liawchinyi/Pre-Aligner/Pre-Aligner.kicad_pcb

## KiCad design Pre-Aligner.kicad_pcb (2022-07-05)

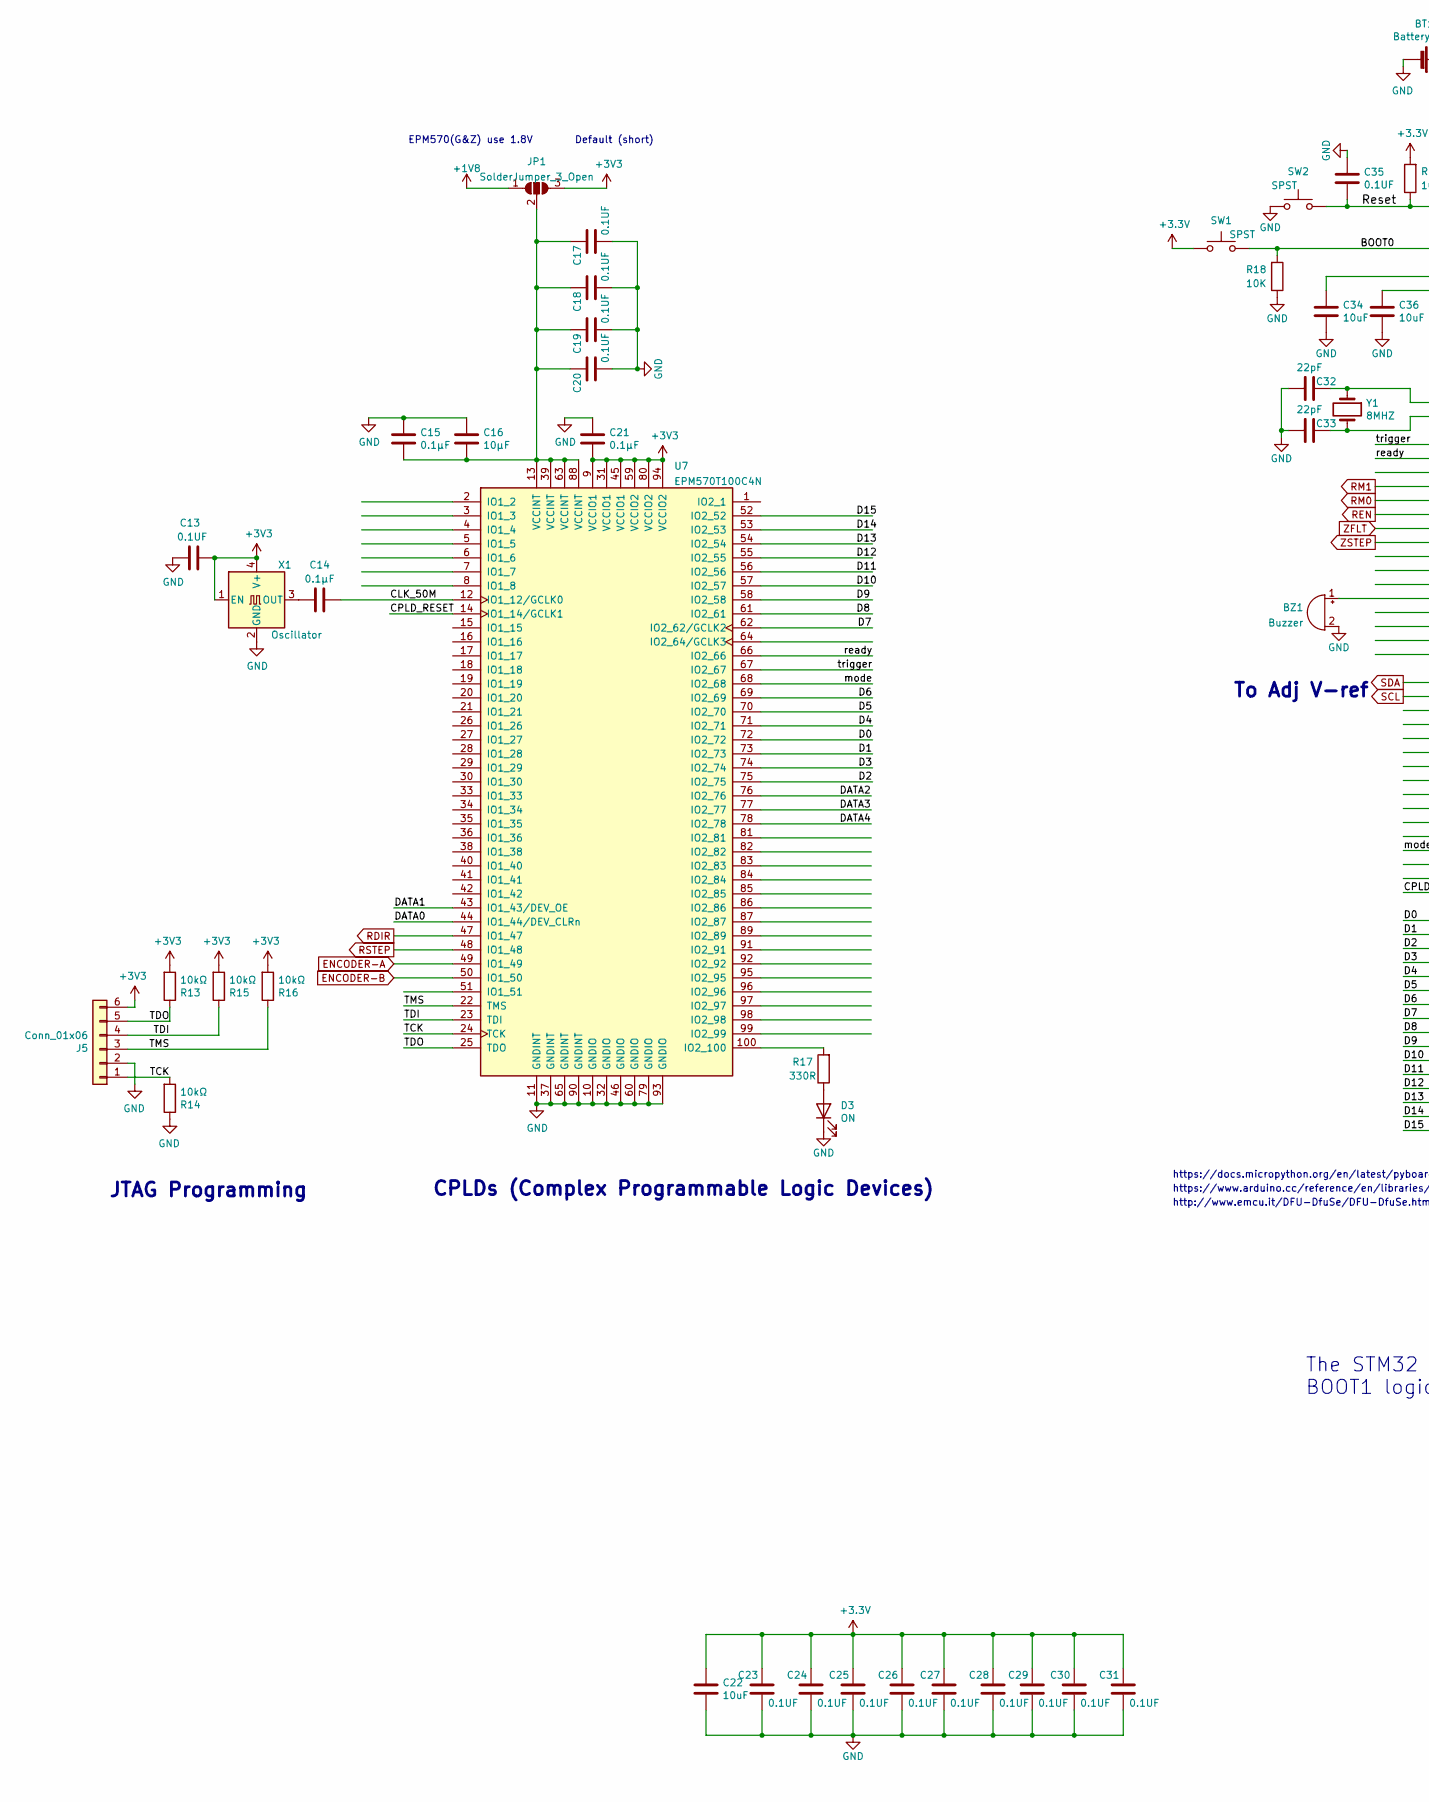
[picture p1: schematic MCU.kicad_sch, Wafer Pre-Aligner, part in row 1, column 1]

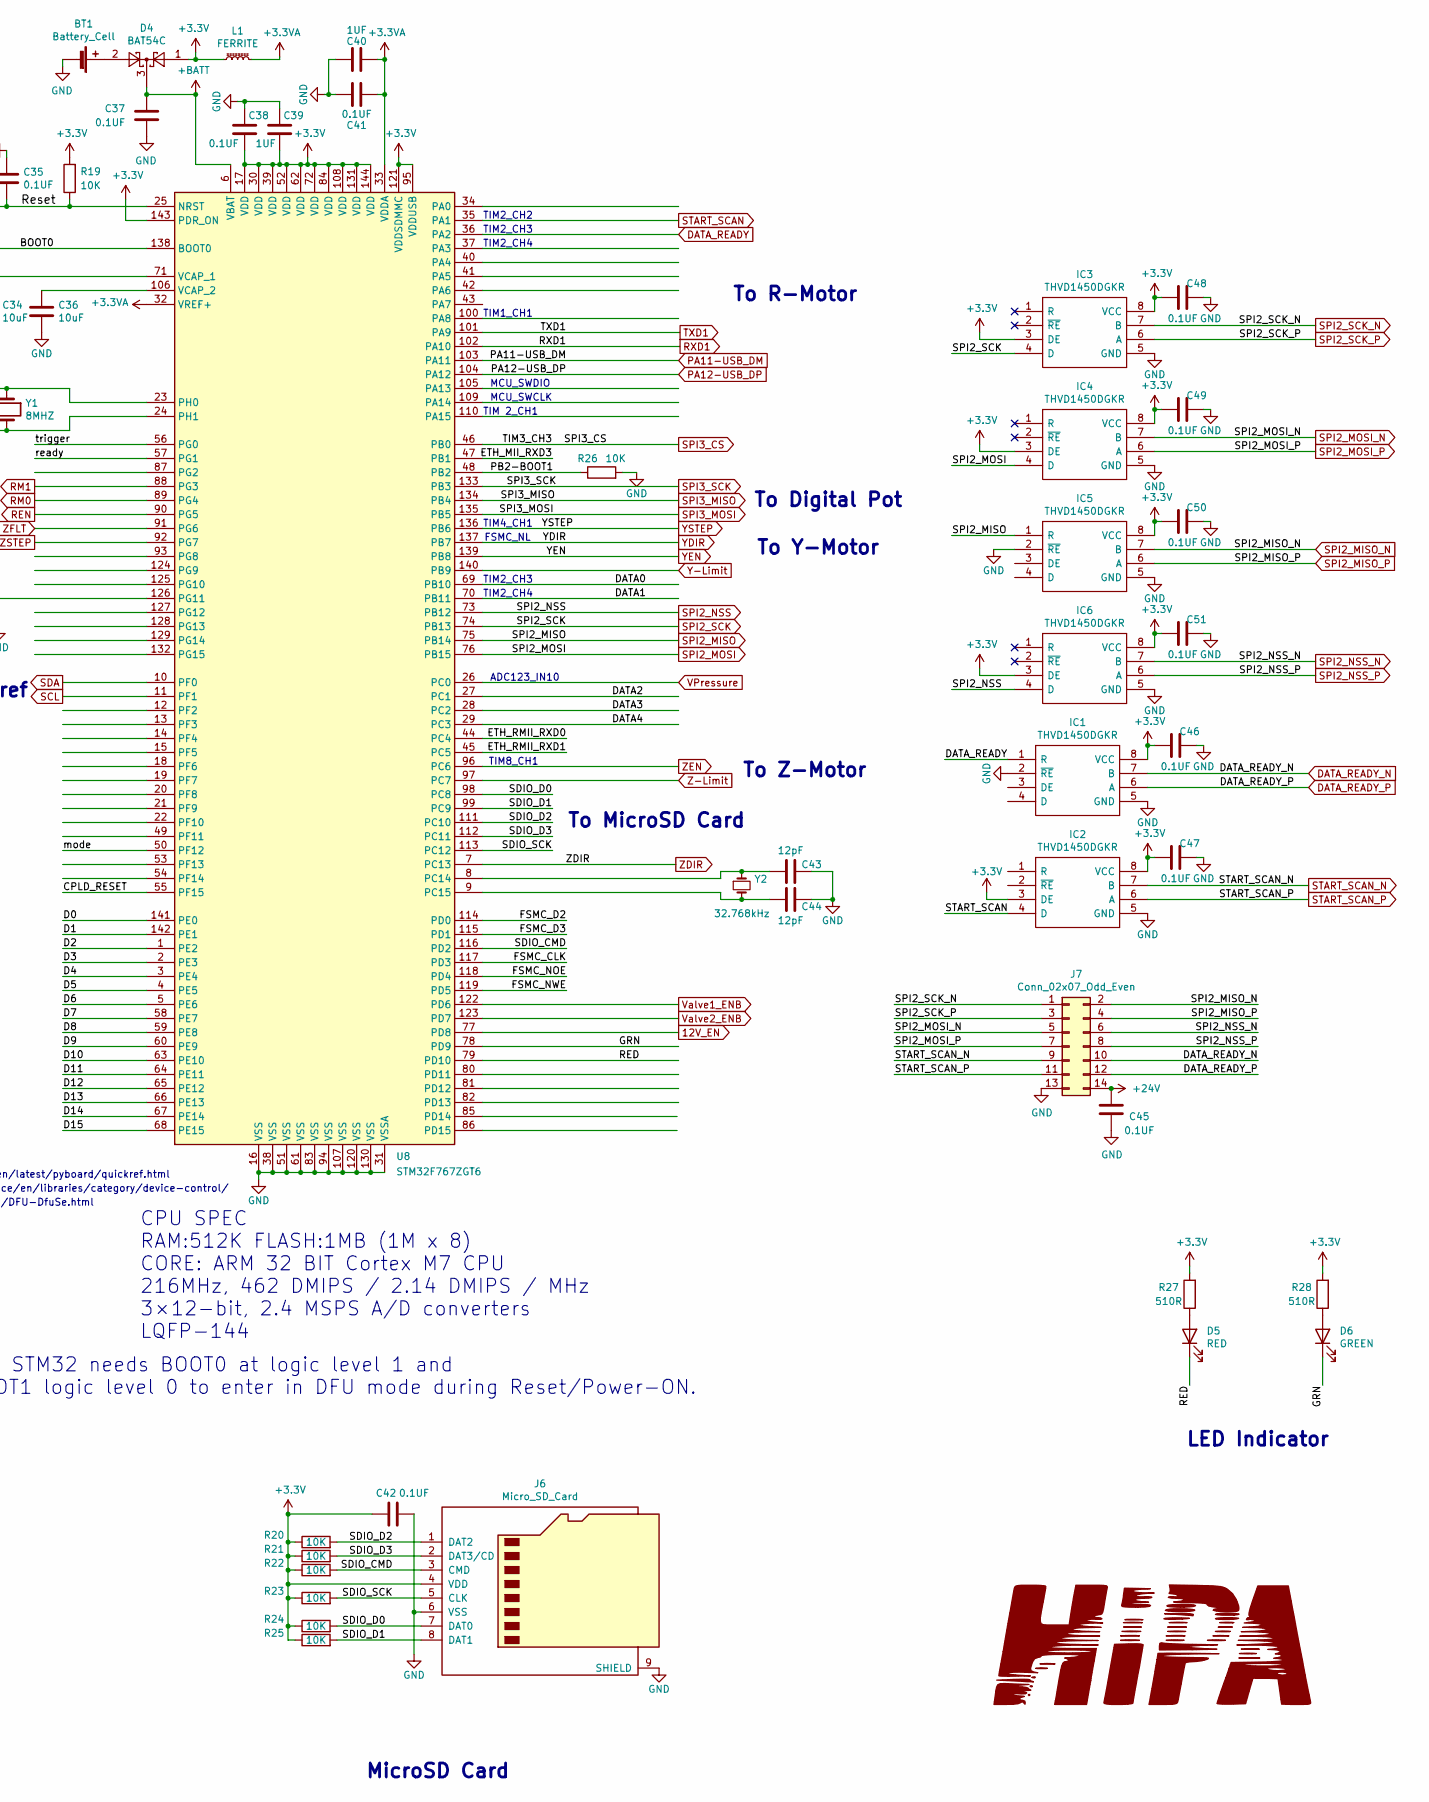
[picture p2: schematic MCU.kicad_sch, Wafer Pre-Aligner, part in row 1, column 2]

Parts:
BT1: Battery_Cell; S8411-45R; Manufacturer_Part_Number S8411-45R
BZ1: Buzzer; MagneticBuzzer_PUI_AT-0927-TT-6-R; Manufacturer_Part_Number AT-0927-TT-6-R
C13, C17, C18, C19, C20, C23, C24, C25, C26, C27, C28, C29, C30, C31, C35, C37, C38, C41, C42, C45, C46, C47, C48, C49, C50, C51: 0.1UF; C_0603_1608Metric; Manufacturer_Part_Number C0603C104M5RACTU
C14: 0.1µF; C_0402_1005Metric; Manufacturer_Part_Number GRM155R71C104KA88J
C15, C21: 0.1µF; C_0603_1608Metric; Manufacturer_Part_Number CC0603KRX7R0BB104
C16: 10µF; C_1210_3225Metric; Manufacturer_Part_Number C1210C106K5RACTU
C22, C34, C36: 10uF; C_0603_1608Metric; Manufacturer_Part_Number GRM188D71A106KA73D
C32, C33: 22pF; C_0603_1608Metric; Manufacturer_Part_Number C0603C220J1GACTU
C39, C40: 1UF; C_0603_1608Metric; Manufacturer_Part_Number CL10B105MO8NNWC
C43, C44: 12pF; C_0402_1005Metric; Manufacturer_Part_Number 04025A120FAT2A
D3: ON; LED_0805_2012Metric; Manufacturer_Part_Number LTST-C171GKT
D4: BAT54C; SOT-23; Manufacturer_Part_Number BAT54C
D5: RED; LED_0805_2012Metric; Manufacturer_Part_Number LTST-C171KRKT
D6: GREEN; LED_0805_2012Metric; Manufacturer_Part_Number LTST-C171GKT
IC1, IC2, IC3, IC4, IC5, IC6: THVD1450DGKR; SOP65P490X110-8N; Manufacturer_Part_Number THVD1450DGKR; Mouser Part Number 595-THVD1450DGKR
J5: Conn_01x06; Molex_PicoBlade_53047-0610_1x06_P1.25mm_Vertical; Manufacturer_Part_Number 0530470610
J6: Micro_SD_Card; microSD_HC_Wuerth_693072010801; Manufacturer_Part_Number 693072010801
J7: Conn_02x07_Odd_Even; PinHeader_2x07_P2.54mm_Vertical; Manufacturer_Part_Number 5103308-2
JP1: SolderJumper_3_Open; SolderJumper-3_P1.3mm_Open_RoundedPad1.0x1.5mm_NumberLabels; Manufacturer_Part_Number Empty Do not mount
L1: FERRITE; L_0603_1608Metric; Manufacturer_Part_Number 742792651
R13, R14, R15, R16: 10kΩ; R_0603_1608Metric; Manufacturer_Part_Number RNCP0603FTD10K0
R17: 330R; R_0603_1608Metric; Manufacturer_Part_Number RC0603FR-07330RL
R18, R19, R20, R21, R22, R23, R24, R25, R26: 10K; R_0603_1608Metric; Manufacturer_Part_Number ERJ-3GEYJ103V
R27, R28: 510R; R_0603_1608Metric; Manufacturer_Part_Number RC0603JR-07510RL
SW1, SW2: SPST; SW_SPST_TL3342; Manufacturer_Part_Number TL3342F160QG/TR
U7: EPM570T100C4N; LQFP-100_14x14mm_P0.5mm; Manufacturer_Part_Number EPM570T100C4N
U8: STM32F767ZGT6; LQFP-144_20x20mm_P0.5mm; Manufacturer_Part_Number STM32F767ZGT6
X1: Oscillator; Oscillator_SMD_EuroQuartz_XO32-4Pin_3.2x2.5mm; Manufacturer_Part_Number ECS-2033-500-BN
Y1: 8MHZ; Crystal_SMD_Abracon_ABM7-2Pin_6.0x3.5mm; Manufacturer_Part_Number ABM7-8.000MHZ-D2Y-T
Y2: 32.768kHz; Crystal_SMD_2012-2Pin_2.0x1.2mm_HandSoldering; Manufacturer_Part_Number SC20S-12.5PF20PPM

Connections:
12V_EN: U8.77 (PD8); also elsewhere on the board
24V: C45.1, J7.14; also elsewhere on the board
+1V8: JP1.1 (A); also elsewhere on the board
+3.3VA: C40.2, C41.2, L1.2, U8.32 (VREF+), U8.33 (VDDA)
+BATT: C37.1, D4.3, U8.6 (VBAT)
/MCU/BOOT0: R18.2, SW1.2, U8.138 (BOOT0)
/MCU/CLK_50M: C14.2, U7.12 (IO1_12/GCLK0)
/MCU/CPLD_RESET: U7.14 (IO1_14/GCLK1), U8.55 (PF15)
/MCU/D0: U7.72 (IO2_72), U8.141 (PE0)
/MCU/D1: U7.73 (IO2_73), U8.142 (PE1)
/MCU/D2: U7.75 (IO2_75), U8.1 (PE2)
/MCU/D3: U7.74 (IO2_74), U8.2 (PE3)
/MCU/D4: U7.71 (IO2_71), U8.3 (PE4)
/MCU/D5: U7.70 (IO2_70), U8.4 (PE5)
/MCU/D6: U7.69 (IO2_69), U8.5 (PE6)
/MCU/D7: U7.62 (IO2_62/GCLK2), U8.58 (PE7)
/MCU/D8: U7.61 (IO2_61), U8.59 (PE8)
/MCU/D9: U7.58 (IO2_58), U8.60 (PE9)
/MCU/D10: U7.57 (IO2_57), U8.63 (PE10)
/MCU/D11: U7.56 (IO2_56), U8.64 (PE11)
/MCU/D12: U7.55 (IO2_55), U8.65 (PE12)
/MCU/D13: U7.54 (IO2_54), U8.66 (PE13)
/MCU/D14: U7.53 (IO2_53), U8.67 (PE14)
/MCU/D15: U7.52 (IO2_52), U8.68 (PE15)
/MCU/DATA0: U7.44 (IO1_44/DEV_CLRn), U8.69 (PB10)
/MCU/DATA1: U7.43 (IO1_43/DEV_OE), U8.70 (PB11)
/MCU/DATA2: U7.76 (IO2_76), U8.27 (PC1)
/MCU/DATA3: U7.77 (IO2_77), U8.28 (PC2)
/MCU/DATA4: U7.78 (IO2_78), U8.29 (PC3)
/MCU/ETH_MII_RXD3: U8.47 (PB1)
/MCU/ETH_RMII_RXD0: U8.44 (PC4)
/MCU/ETH_RMII_RXD1: U8.45 (PC5)
/MCU/FSMC_CLK: U8.117 (PD3)
/MCU/FSMC_D2: U8.114 (PD0)
/MCU/FSMC_D3: U8.115 (PD1)
/MCU/FSMC_NOE: U8.118 (PD4)
/MCU/FSMC_NWE: U8.119 (PD5)
/MCU/GRN: D6.1 (K), U8.78 (PD9)
/MCU/PB2-BOOT1: R26.1, U8.48 (PB2)
/MCU/RED: D5.1 (K), U8.79 (PD10)
/MCU/Reset: C35.1, R19.1, SW2.2, U8.25 (NRST)
/MCU/SDIO_CMD: J6.3 (CMD), R22.2, U8.116 (PD2)
/MCU/SDIO_D0: J6.7 (DAT0), R24.2, U8.98 (PC8)
/MCU/SDIO_D1: J6.8 (DAT1), R25.2, U8.99 (PC9)
/MCU/SDIO_D2: J6.1 (DAT2), R20.2, U8.111 (PC10)
/MCU/SDIO_D3: J6.2 (DAT3/CD), R21.2, U8.112 (PC11)
/MCU/SDIO_SCK: J6.5 (CLK), R23.2, U8.113 (PC12)
/MCU/TCK: J5.1, R14.2, U7.24 (TCK)
/MCU/TDI: J5.4, R15.1, U7.23 (TDI)
/MCU/TDO: J5.5, R13.1, U7.25 (TDO)
/MCU/TMS: J5.3, R16.1, U7.22 (TMS)
/MCU/mode: U7.68 (IO2_68), U8.50 (PF12)
/MCU/ready: U7.66 (IO2_66), U8.57 (PG1)
/MCU/trigger: U7.67 (IO2_67), U8.56 (PG0)
DATA_READY: IC1.1 (R), U8.36 (PA2)
DATA_READY_N: IC1.7 (B), J7.10
DATA_READY_P: IC1.6 (A), J7.12
ENCODER-A: U7.49 (IO1_49); also elsewhere on the board
ENCODER-B: U7.50 (IO1_50); also elsewhere on the board
GND: BT1.2 (-), BZ1.2 (+), C13.1, C15.1, C16.1, C17.1, C18.1, C19.1, C20.1, C21.1, C22.1, C23.1, C24.1, C25.1, C26.1, C27.1, C28.1, C29.1, C30.1, C31.1, C32.2, C33.2, C34.1, C35.2, C36.1, C37.2, C38.2, C39.2, C40.1, C41.1, C42.1, C43.1, C44.2, C45.2, C46.2, C47.2, C48.2, C49.2, C50.2, C51.2, D3.1 (K), IC1.2 (~RE), IC1.5 (GND), IC2.5 (GND), IC3.5 (GND), IC4.5 (GND), IC5.2 (~RE), IC5.5 (GND), IC6.5 (GND), J5.2, J6.6 (VSS), J6.9 (SHIELD), J7.13, R14.1, R18.1, R26.2, SW2.1, U7.10 (GNDIO), U7.11 (GNDINT), U7.32 (GNDIO), U7.37 (GNDINT), U7.46 (GNDIO), U7.60 (GNDIO), U7.65 (GNDINT), U7.79 (GNDIO), U7.90 (GNDINT), U7.93 (GNDIO), U8.16 (VSS), U8.31 (VSSA), U8.38 (VSS), U8.51 (VSS), U8.61 (VSS), U8.83 (VSS), U8.94 (VSS), U8.107 (VSS), U8.120 (VSS), U8.130 (VSS), X1.2 (GND); also elsewhere on the board
unnamed: BT1.1 (+), D4.2
unnamed: BZ1.1 (-), U8.126 (PG11)
unnamed: C14.1, X1.3 (OUT)
unnamed: C15.2, C16.2, C17.2, C18.2, C19.2, C20.2, JP1.2 (C), U7.13 (VCCINT), U7.39 (VCCINT), U7.63 (VCCINT), U7.88 (VCCINT)
unnamed: C32.1, U8.23 (PH0), Y1.1
unnamed: C33.1, U8.24 (PH1), Y1.2
unnamed: C34.2, U8.71 (VCAP_1)
unnamed: C36.2, U8.106 (VCAP_2)
unnamed: C43.2, U8.8 (PC14), Y2.1
unnamed: C44.1, U8.9 (PC15), Y2.2
unnamed: D3.2 (A), R17.1
unnamed: D5.2 (A), R27.1
unnamed: D6.2 (A), R28.1
unnamed: R17.2, U7.100 (IO2_100)
PA11-USB_DM: U8.103 (PA11); also elsewhere on the board
PA12-USB_DP: U8.104 (PA12); also elsewhere on the board
RDIR: U7.47 (IO1_47); also elsewhere on the board
REN: U8.90 (PG5); also elsewhere on the board
RM0: U8.89 (PG4); also elsewhere on the board
RM1: U8.88 (PG3); also elsewhere on the board
RSTEP: U7.48 (IO1_48); also elsewhere on the board
RXD1: U8.102 (PA10); also elsewhere on the board
SCL: U8.11 (PF1); also elsewhere on the board
SDA: U8.10 (PF0); also elsewhere on the board
SPI2_MISO: IC5.1 (R), U8.75 (PB14)
SPI2_MISO_N: IC5.7 (B), J7.2
SPI2_MISO_P: IC5.6 (A), J7.4
SPI2_MOSI: IC4.4 (D), U8.76 (PB15)
SPI2_MOSI_N: IC4.7 (B), J7.5
SPI2_MOSI_P: IC4.6 (A), J7.7
SPI2_NSS: IC6.4 (D), U8.73 (PB12)
SPI2_NSS_N: IC6.7 (B), J7.6
SPI2_NSS_P: IC6.6 (A), J7.8
SPI2_SCK: IC3.4 (D), U8.74 (PB13)
SPI2_SCK_N: IC3.7 (B), J7.1
SPI2_SCK_P: IC3.6 (A), J7.3
SPI3_CS: U8.46 (PB0); also elsewhere on the board
SPI3_MISO: U8.134 (PB4)
SPI3_MOSI: U8.135 (PB5); also elsewhere on the board
SPI3_SCK: U8.133 (PB3); also elsewhere on the board
START_SCAN: IC2.4 (D), U8.35 (PA1)
START_SCAN_N: IC2.7 (B), J7.9
START_SCAN_P: IC2.6 (A), J7.11
TXD1: U8.101 (PA9); also elsewhere on the board
VPressure: U8.26 (PC0); also elsewhere on the board
Valve1_ENB: U8.122 (PD6); also elsewhere on the board
Valve2_ENB: U8.123 (PD7); also elsewhere on the board
Y-Limit: U8.140 (PB9); also elsewhere on the board
YDIR: U8.137 (PB7); also elsewhere on the board
YEN: U8.139 (PB8); also elsewhere on the board
YSTEP: U8.136 (PB6); also elsewhere on the board
Z-Limit: U8.97 (PC7); also elsewhere on the board
ZDIR: U8.7 (PC13); also elsewhere on the board
ZEN: U8.96 (PC6); also elsewhere on the board
ZFLT: U8.91 (PG6); also elsewhere on the board
ZSTEP: U8.92 (PG7); also elsewhere on the board

Notes on the sheet:
TIM2_CH4
TIM4_CH1
TIM2_CH3
MicroSD Card
To Z-Motor
LED Indicator
TIM8_CH1
ADC123_IN10
http://www.emcu.it/DFU-DfuSe/DFU-DfuSe.html
To MicroSD Card
MCU_SWDIO
Default (short)
https://docs.micropython.org/en/latest/pyboard/quickref.html
TIM 2_CH1
TIM1_CH1
CPU SPEC RAM:512K FLASH:1MB (1M x 8) CORE: ARM 32 BIT Cortex M7 CPU 216MHz, 462 DMIPS / 2.14 DMIPS / MHz 3×12-bit, 2.4 MSPS A/D converters LQFP-144
CPLDs (Complex Programmable Logic Devices)
MCU_SWCLK
https://www.arduino.cc/reference/en/libraries/category/device-control/
To Y-Motor
TIM2_CH2
JTAG Programming
FSMC_NL
To Adj V-ref
To R-Motor
The STM32 needs BOOT0 at logic level 1 and BOOT1 logic level 0 to enter in DFU mode during Reset/Power-ON.
To Digital Pot
EPM570(G&Z) use 1.8V

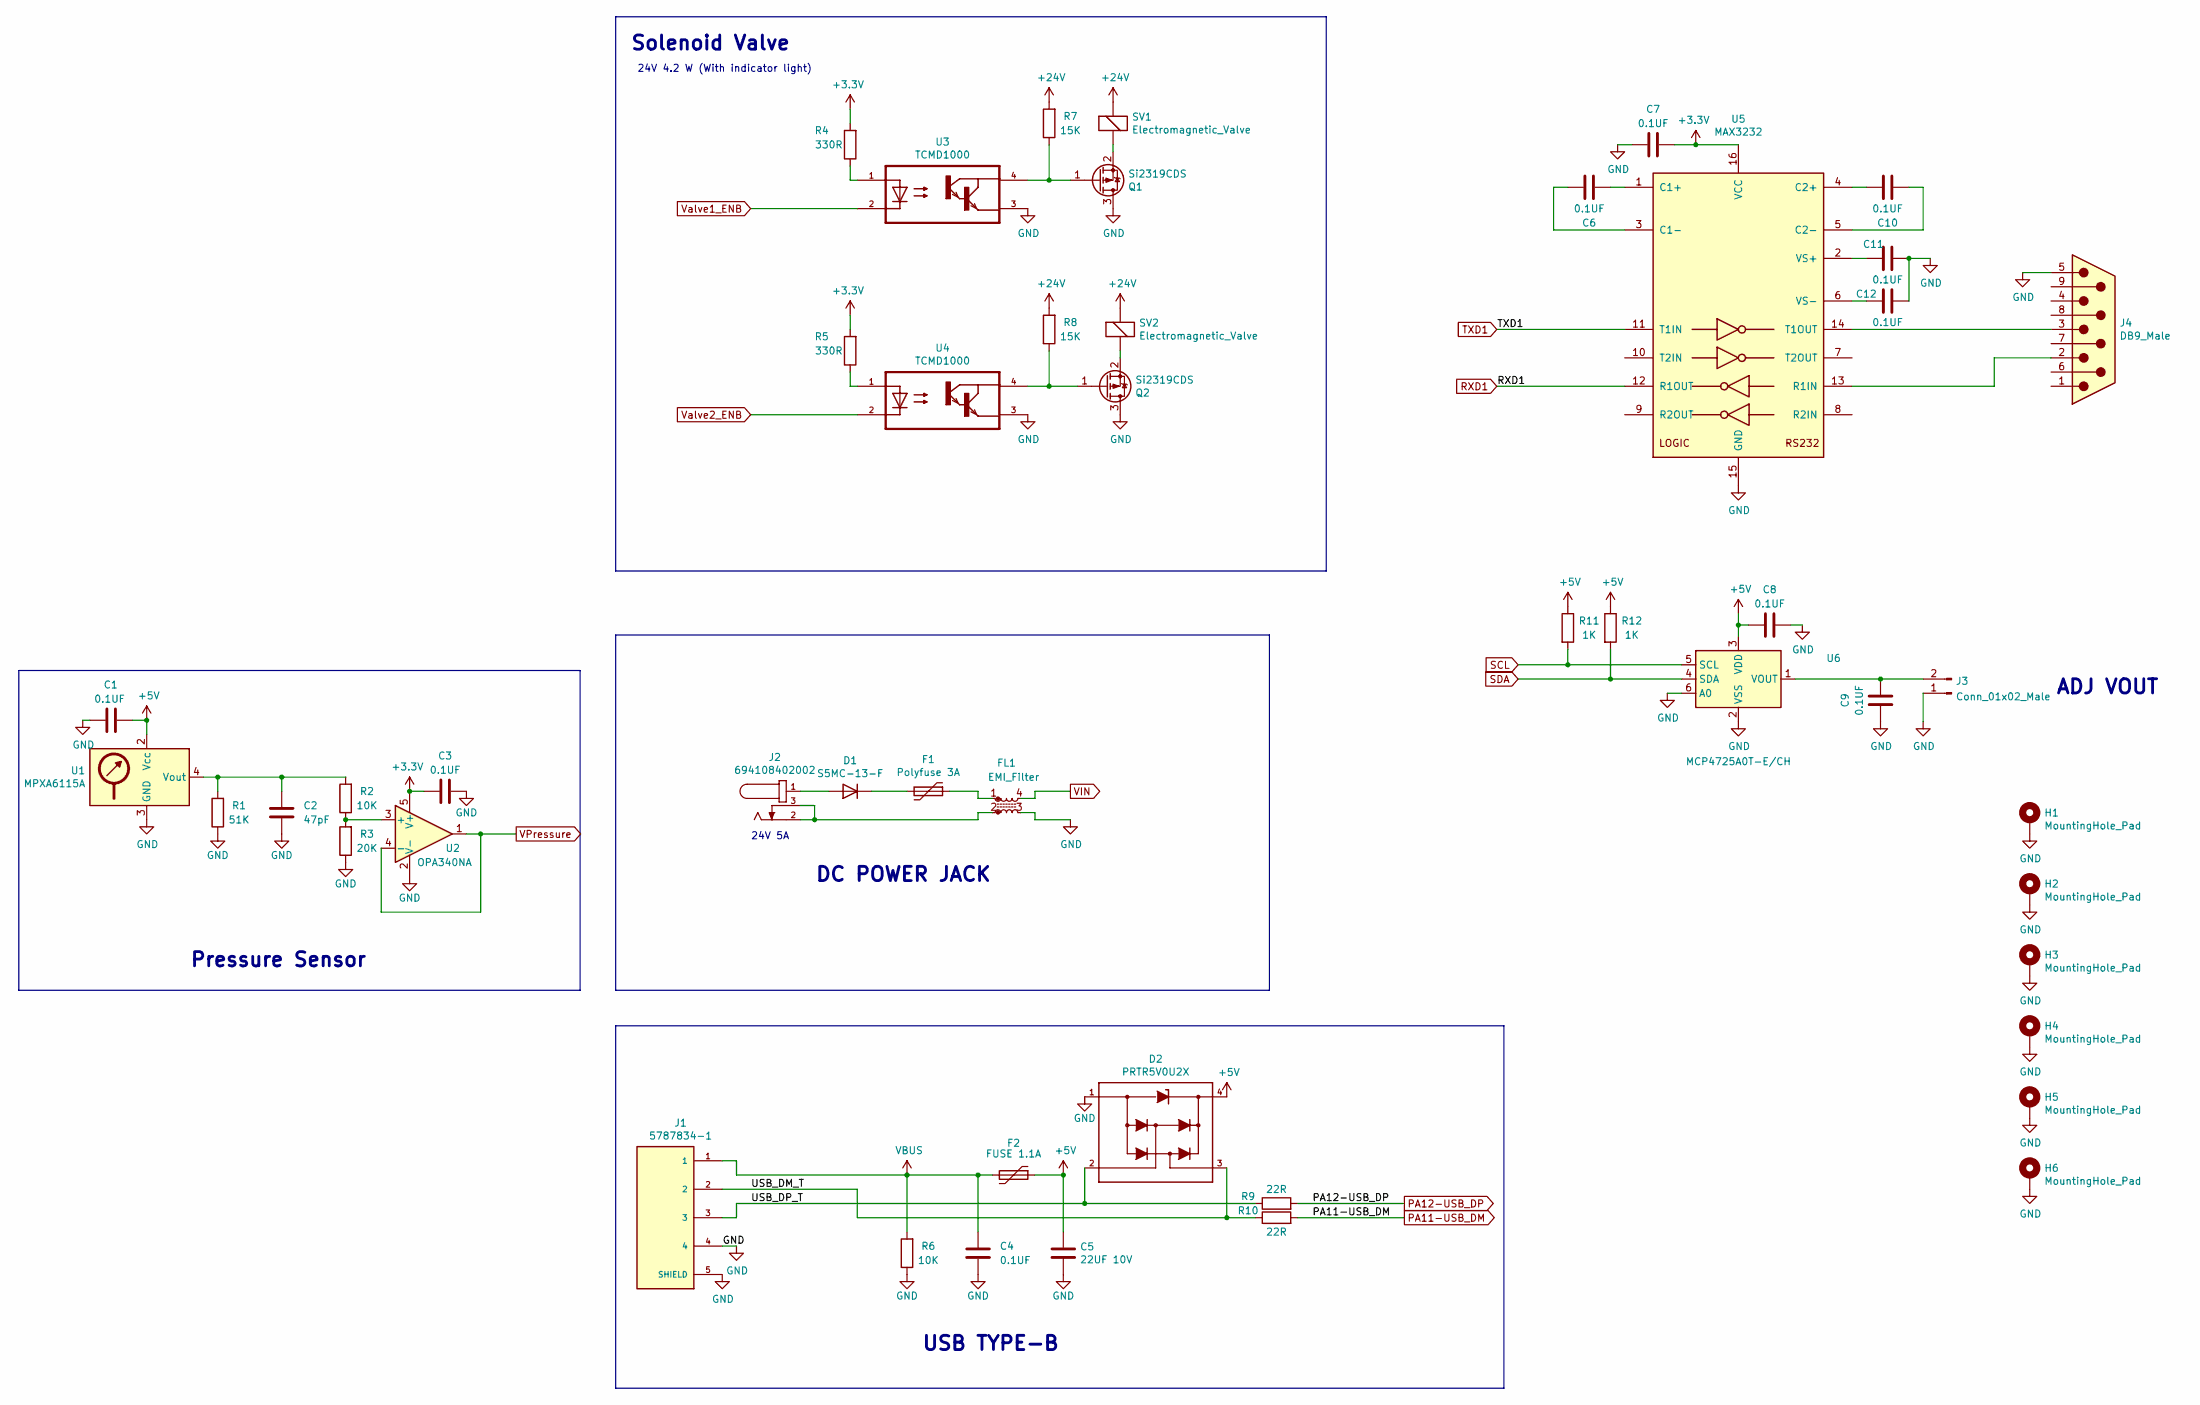
[picture p3: schematic Interface.kicad_sch]

Parts:
C1, C3, C4, C6, C7, C8, C9, C10, C11, C12: 0.1UF; C_0603_1608Metric; Manufacturer_Part_Number C0603C104M5RACTU
C2: 47pF; C_0603_1608Metric; Manufacturer_Part_Number 251R14S470GV4T
C5: 22UF 10V; C_0805_2012Metric; Manufacturer_Part_Number GRM21BR61A226ME51L
D1: S5MC-13-F; Manufacturer_Part_Number S5MC-13-F
D2: PRTR5V0U2X; SOT190P230X110-4N; Manufacturer_Part_Number PRTR5V0U2X,215
F1: Polyfuse 3A; Fuse_Bourns_MF-RHT1300; Manufacturer_Part_Number MF-RX300/72-2
F2: FUSE 1.1A; Fuse_1812_4532Metric_Pad1.30x3.40mm_HandSolder; Manufacturer_Part_Number 1812L110/33MR
FL1: EMI_Filter; ACM7060-701-2PL-TL; Manufacturer_Part_Number ACM7060-701-2PL-TL01
H1, H2, H3, H4, H5, H6: MountingHole_Pad; MountingHole_3.5mm_Pad; Manufacturer_Part_Number Empty Do not mount
J1: 5787834-1; USB_B_TE_5787834_Vertical; Manufacturer_Part_Number 5787834-1
J2: 694108402002; Manufacturer_Part_Number 694108402002
J3: Conn_01x02_Male; Molex_KK-254_AE-6410-02A_1x02_P2.54mm_Vertical; Manufacturer_Part_Number 0022272021
J4: DB9_Male; DSUB-9_Male_Vertical_P2.77x2.84mm_MountingHoles; Manufacturer_Part_Number 5747871-8
Q1, Q2: Si2319CDS; SOT-23; Manufacturer_Part_Number SI2319CDS-T1-BE3
R1: 51K; R_0603_1608Metric; Manufacturer_Part_Number RR0816P-513-D
R2, R6: 10K; R_0603_1608Metric; Manufacturer_Part_Number ERJ-3GEYJ103V
R3: 20K; R_0603_1608Metric; Manufacturer_Part_Number ERA-3AEB203V
R4, R5: 330R; R_0603_1608Metric; Manufacturer_Part_Number RC0603JR-07330RL
R7, R8: 15K; R_0603_1608Metric; Manufacturer_Part_Number ERA-3AEB153V
R9, R10: 22R; R_0603_1608Metric; Manufacturer_Part_Number RC0603FR-0722RL
R11, R12: 1K; R_0603_1608Metric; Manufacturer_Part_Number RC0603JR-071KL
SV1, SV2: Electromagnetic_Valve; Molex_KK-254_AE-6410-02A_1x02_P2.54mm_Vertical; Manufacturer_Part_Number 0022272021
U1: MPXA6115A; SOP254P1821X584-8N; Manufacturer_Part_Number MPXA6115AC6U
U2: OPA340NA; SOT-23-5; Manufacturer_Part_Number OPA340NA/3K
U3, U4: TCMD1000; SOP127P695X210-4N; Manufacturer_Part_Number TCMD1000
U5: MAX3232; SOIC-16_3.9x9.9mm_P1.27mm; Manufacturer_Part_Number MAX3232ESE+T
U6: MCP4725A0T-E/CH; SOT-23-6; Manufacturer_Part_Number MCP4725A0T-E/CH

Connections:
24V: R7.2, R8.2, SV1.1 (-), SV2.1 (-); also elsewhere on the board
+5V: C1.2, C5.1, C8.2, D2.4, F2.1, R11.1, R12.1, U1.2 (Vcc), U6.3 (VDD); also elsewhere on the board
/Interface/USB_DM_T: D2.3, J1.2, R10.1
/Interface/USB_DP_T: D2.2, J1.3, R9.1
GND: C1.1, C2.2, C3.1, C4.2, C5.2, C7.2, C8.1, C9.2, C11.2, C12.2, D2.1, FL1.3, H1.1, H2.1, H3.1, H4.1, H5.1, H6.1, J1.4, J1.5 (SHIELD), J3.1, J4.5, Q1.3 (D), Q2.3 (D), R1.1, R3.1, R6.1, U1.3 (GND), U2.2 (V-), U3.3, U4.3, U5.15 (GND), U6.2 (VSS), U6.6 (A0); also elsewhere on the board
unnamed: C2.1, R1.2, R2.2, U1.4 (Vout)
unnamed: C6.1, U5.3 (C1-)
unnamed: C6.2, U5.1 (C1+)
unnamed: C9.1, J3.2, U6.1 (VOUT)
unnamed: C10.1, U5.4 (C2+)
unnamed: C10.2, U5.5 (C2-)
unnamed: C11.1, U5.2 (VS+)
unnamed: C12.1, U5.6 (VS-)
unnamed: D1.1 (K), F1.2
unnamed: D1.2 (A), J2.1
unnamed: F1.1, FL1.1
unnamed: FL1.2, J2.2, J2.3
unnamed: J4.2, U5.13 (R1IN)
unnamed: J4.3, U5.14 (T1OUT)
unnamed: Q1.1 (G), R7.1, U3.4
unnamed: Q1.2 (S), SV1.2 (+)
unnamed: Q2.1 (G), R8.1, U4.4
unnamed: Q2.2 (S), SV2.2 (+)
unnamed: R2.1, R3.2, U2.3 (+)
unnamed: R4.1, U3.1
unnamed: R5.1, U4.1
PA11-USB_DM: R10.2; also elsewhere on the board
PA12-USB_DP: R9.2; also elsewhere on the board
RXD1: U5.12 (R1OUT); also elsewhere on the board
SCL: R11.2, U6.5 (SCL); also elsewhere on the board
SDA: R12.2, U6.4 (SDA); also elsewhere on the board
TXD1: U5.11 (T1IN); also elsewhere on the board
VBUS: C4.1, F2.2, J1.1, R6.2
VIN: FL1.4; also elsewhere on the board
VPressure: U2.1, U2.4 (-); also elsewhere on the board
Valve1_ENB: U3.2; also elsewhere on the board
Valve2_ENB: U4.2; also elsewhere on the board

Notes on the sheet:
USB TYPE-B
ADJ VOUT
24V 4.2 W (With indicator light)
Pressure Sensor
24V 5A
Solenoid Valve
DC POWER JACK

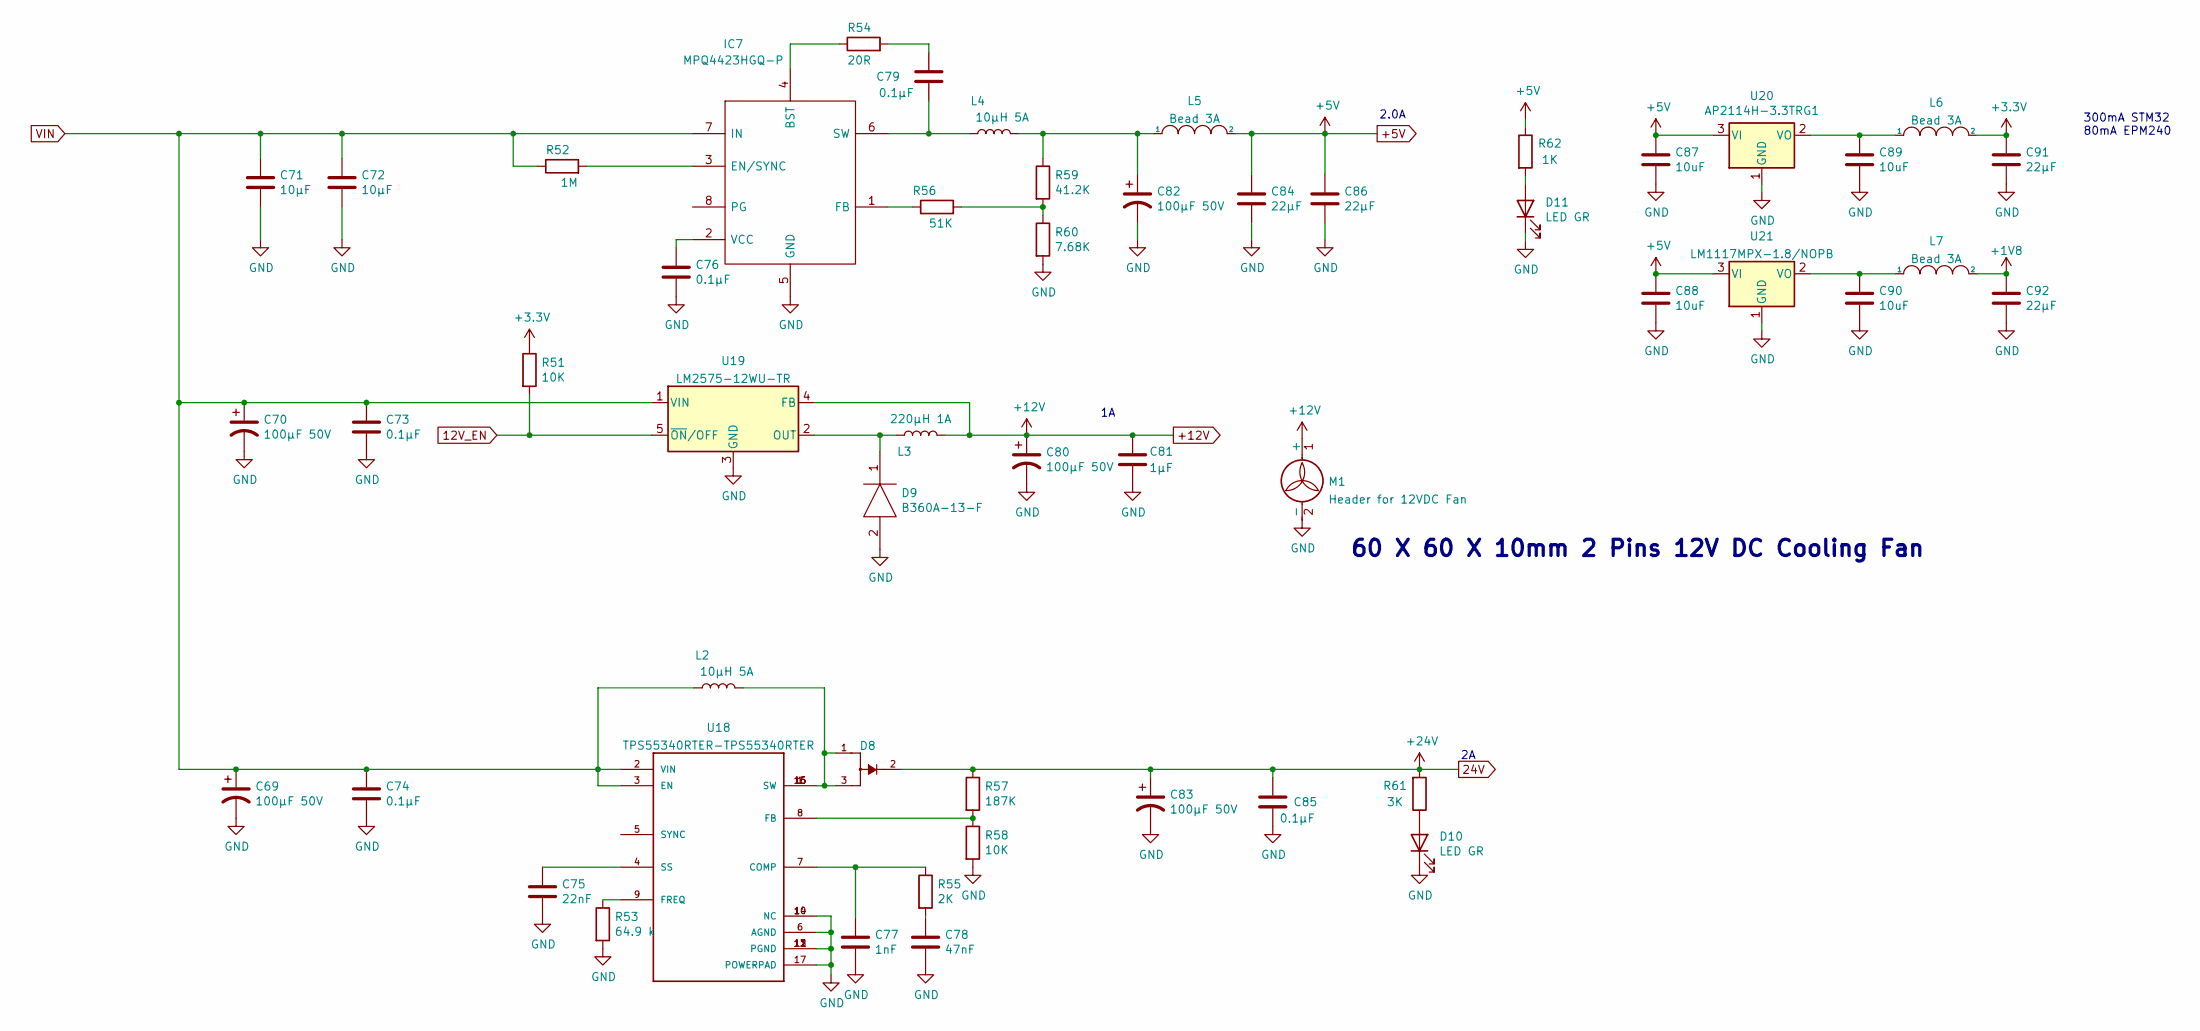
[picture p4: schematic Power Supply.kicad_sch]

Parts:
C69, C70, C80, C82, C83: 100µF 50V; CP_Elec_10x10; Manufacturer_Part_Number EEE-FC1H101P
C71, C72: 10µF; C_1210_3225Metric; Manufacturer_Part_Number C1210C106K5RACTU
C73, C74, C76, C79: 0.1µF; C_0603_1608Metric; Manufacturer_Part_Number CC0603KRX7R0BB104
C75: 22nF; C_0603_1608Metric; Manufacturer_Part_Number MC0603B223K500CT
C77: 1nF; C_0603_1608Metric; Manufacturer_Part_Number CC0603KRX7R9BB102
C78: 47nF; C_0603_1608Metric; Manufacturer_Part_Number MC0603B473K500CT
C81: 1µF; C_0603_1608Metric; Manufacturer_Part_Number Samsung Electro-Mechanics
C84, C86, C91, C92: 22µF; C_1210_3225Metric; Manufacturer_Part_Number CGA6P1X7R1C226M250AC
C85: 0.1µF; C_0402_1005Metric; Manufacturer_Part_Number GRM155R71C104KA88J
C87, C88, C89, C90: 10uF; C_0603_1608Metric; Manufacturer_Part_Number GRM188D71A106KA73D
D8: SBRD10200TR; ATPAK-2; Manufacturer_Part_Number SBRD10200
D9: B360A-13-F; DIOM5226X240N; Manufacturer_Part_Number B360A-13-F; Mouser Part Number 621-B360A-F
D10: LED GR; LED_D5.0mm; Manufacturer_Part_Number LTL-307GLC
D11: LED GR; LED_0805_2012Metric; Manufacturer_Part_Number LTST-C171GKT
IC7: MPQ4423HGQ-P; SON65P300X300X100-8N-D; Manufacturer_Part_Number MPQ4423HGQ-P; Mouser Part Number 946-MPQ4423HGQ-P
L2, L4: 10µH 5A; L_12x12mm_H6mm; Manufacturer_Part_Number 74477110
L3: 220µH 1A; L_Wuerth_HCM-7070; Manufacturer_Part_Number 74404084221
L5, L6, L7: Bead 3A; L_1210_3225Metric; Manufacturer_Part_Number FBMH3225HM601NT
M1: Header for 12VDC Fan; Molex_KK-254_AE-6410-02A_1x02_P2.54mm_Vertical; Manufacturer_Part_Number 0022272021
R51: 10K; R_0603_1608Metric; Manufacturer_Part_Number RT0603DRD0710KL
R52: 1M; R_0603_1608Metric; Manufacturer_Part_Number HVCB0603FDC1M00
R53: 64.9 k; R_0603_1608Metric; Manufacturer_Part_Number RC0603FR-0764K9L
R54: 20R; R_0603_1608Metric; Manufacturer_Part_Number RC0603FR-0720RL
R55: 2K; R_0603_1608Metric; Manufacturer_Part_Number RNCP0603FTD2K00
R56: 51K; R_0603_1608Metric; Manufacturer_Part_Number RT0603FRE0751KL
R57: 187K; R_0603_1608Metric; Manufacturer_Part_Number RMCF0603FT187K
R58: 10K; R_0603_1608Metric; Manufacturer_Part_Number RNCF0603TKY10K0
R59: 41.2K; R_0603_1608Metric; Manufacturer_Part_Number RMCF0603FT41K2
R60: 7.68K; R_0603_1608Metric; Manufacturer_Part_Number RT0603BRE077K68L
R61: 3K; R_0805_2012Metric; Manufacturer_Part_Number ERA-6AEB302V
R62: 1K; R_0603_1608Metric; Manufacturer_Part_Number RC0603JR-071KL
U18: TPS55340RTER-TPS55340RTER; QFN50P300X300X100-17N; Manufacturer_Part_Number TPS55340RTER
U19: LM2575-12WU-TR; TO-263-5_TabPin3; Manufacturer_Part_Number LM2575-12WU-TR
U20: AP2114H-3.3TRG1; SOT-223-3_TabPin2; Manufacturer_Part_Number AP2114H-3.3TRG1
U21: LM1117MPX-1.8/NOPB; SOT-223-3_TabPin2; Manufacturer_Part_Number LM1117MPX-1.8/NOPB

Connections:
12V_EN: R51.2, U19.5 (~ON/OFF); also elsewhere on the board
24V: C83.1, C85.1, D8.2, R57.1, R61.2; also elsewhere on the board
+1V8: C92.1, L7.2; also elsewhere on the board
+5V: C84.1, C86.1, C87.2, C88.2, L5.2, R62.1, U20.3 (VI), U21.3 (VI); also elsewhere on the board
+12V: C80.1, C81.2, L3.2, M1.1 (+), U19.4 (FB)
GND: C69.2, C70.2, C71.2, C72.2, C73.2, C74.2, C75.2, C76.2, C77.2, C78.2, C80.2, C81.1, C82.2, C83.2, C84.2, C85.2, C86.2, C87.1, C88.1, C89.1, C90.1, C91.2, C92.2, D9.2, D10.1 (K), D11.1 (K), IC7.5 (GND), M1.2 (-), R53.2, R58.2, R60.2, U18.6 (AGND), U18.10 (NC), U18.11 (PGND), U18.12 (PGND), U18.13 (PGND), U18.14 (NC), U18.17 (POWERPAD), U19.3 (GND), U20.1 (GND), U21.1 (GND); also elsewhere on the board
unnamed: C75.1, U18.4 (SS)
unnamed: C76.1, IC7.2 (VCC)
unnamed: C77.1, R55.1, U18.7 (COMP)
unnamed: C78.1, R55.2
unnamed: C79.1, R54.2
unnamed: C79.2, IC7.6 (SW), L4.1
unnamed: C82.1, L4.2, L5.1, R59.1
unnamed: C89.2, L6.1, U20.2 (VO)
unnamed: C90.2, L7.1, U21.2 (VO)
unnamed: D8.1, D8.3, L2.2, U18.1 (SW), U18.15 (SW), U18.16 (SW)
unnamed: D9.1, L3.1, U19.2 (OUT)
unnamed: D10.2 (A), R61.1
unnamed: D11.2 (A), R62.2
unnamed: IC7.1 (FB), R56.1
unnamed: IC7.3 (EN/SYNC), R52.2
unnamed: IC7.4 (BST), R54.1
unnamed: R53.1, U18.9 (FREQ)
unnamed: R56.2, R59.2, R60.1
unnamed: R57.2, R58.1, U18.8 (FB)
VIN: C69.1, C70.1, C71.1, C72.1, C73.1, C74.1, IC7.7 (IN), L2.1, R52.1, U18.2 (VIN), U18.3 (EN), U19.1 (VIN); also elsewhere on the board

Notes on the sheet:
2.0A
300mA STM32 80mA EPM240
60 X 60 X 10mm 2 Pins 12V DC Cooling Fan
