liawchinyi/Pre-Aligner/Pre-Aligner.kicad_pcb

## KiCad design Pre-Aligner.kicad_pcb (continued)

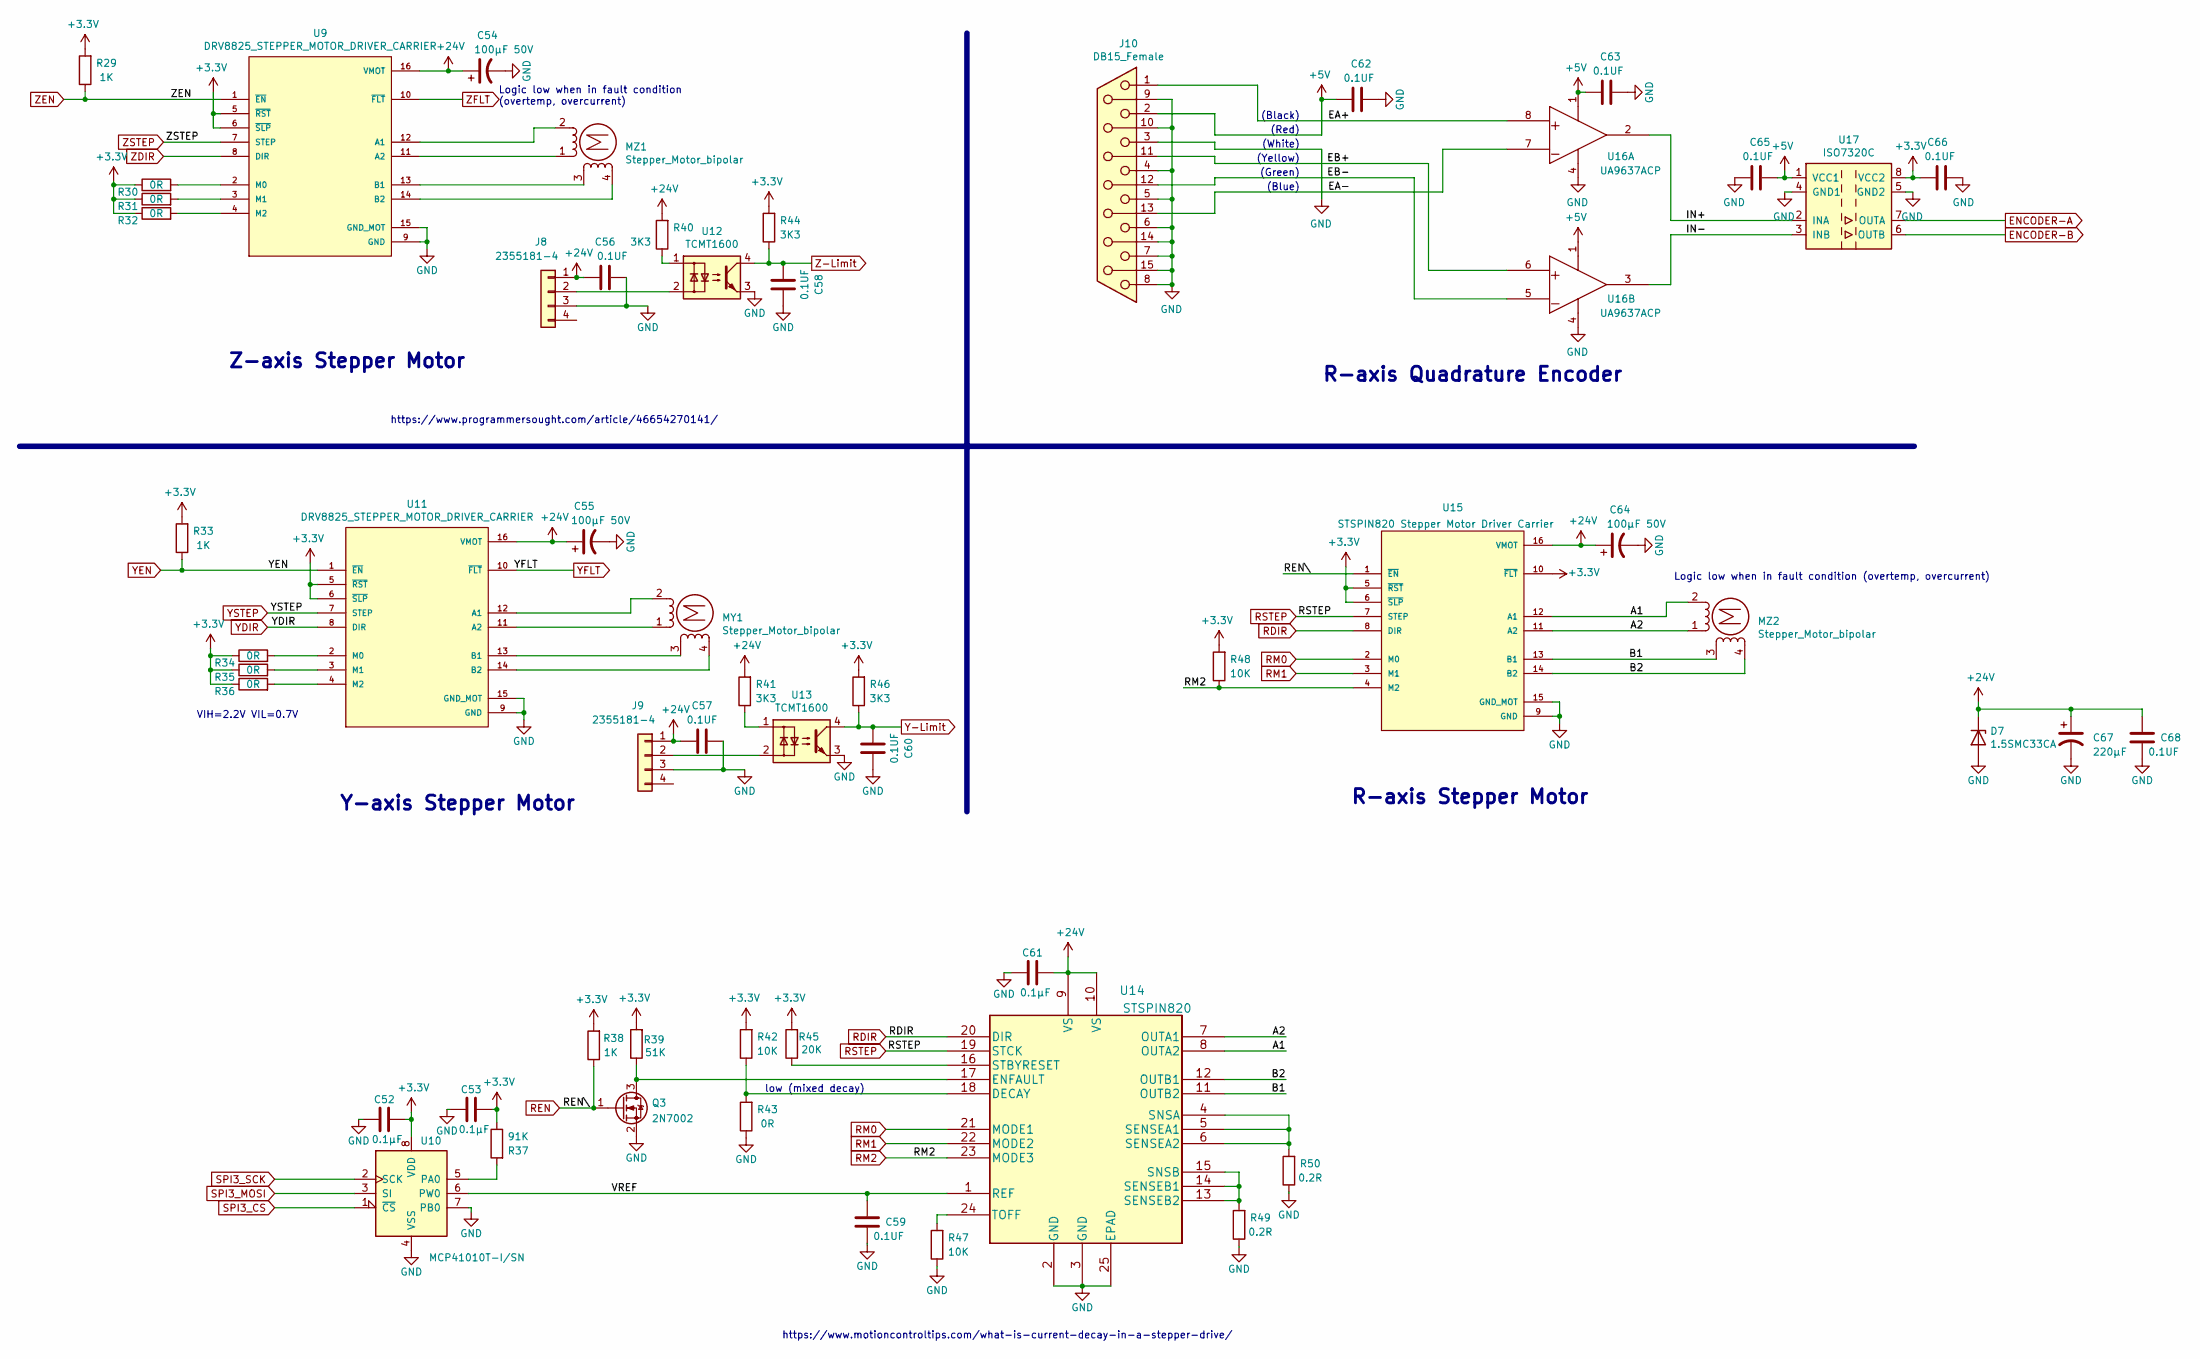
[picture p5: schematic MOTOR.kicad_sch, Wafer Pre-Aligner]

Parts:
C52, C53, C61: 0.1µF; C_0402_1005Metric; Manufacturer_Part_Number GRM155R71C104KA88J
C54, C55, C64: 100µF 50V; CP_Elec_10x10; Manufacturer_Part_Number EEE-FC1H101P
C56, C57, C58, C59, C60, C62, C63, C65, C66, C68: 0.1UF; C_0603_1608Metric; Manufacturer_Part_Number C0603C104M5RACTU
C67: 220µF; CP_Elec_10x10.5; Manufacturer_Part_Number UWT1H221MNL1GS
D7: 1.5SMC33CA; D_SMC; Manufacturer_Part_Number 1.5SMC33CA
J8, J9: 2355181-4; TE_440054-4; Manufacturer_Part_Number 2355181-4
J10: DB15_Female; DSUB-15-HD_Female_Vertical_P2.29x1.98mm_MountingHoles; Manufacturer_Part_Number 10090929-S154XLF
MY1: Stepper_Motor_bipolar; JST_EH_B4B-EH-A_1x04_P2.50mm_Vertical; Manufacturer_Part_Number 640456-4
MZ1, MZ2: Stepper_Motor_bipolar; JST_EH_B4B-EH-A_1x04_P2.50mm_Vertical; Manufacturer_Part_Number 640456-4
Q3: 2N7002; SOT-23; Manufacturer_Part_Number 2N7002
R29, R33, R38: 1K; R_0603_1608Metric; Manufacturer_Part_Number RC0603JR-071KL
R30, R31, R32, R34, R35, R36: 0R; R_0603_1608Metric; Manufacturer_Part_Number RMCF0603ZT0R00
R37: 91K; R_0603_1608Metric; Manufacturer_Part_Number ERJ-3GEYJ913V
R39: 51K; R_0603_1608Metric; Manufacturer_Part_Number RT0603FRE0751KL
R40, R41, R44, R46: 3K3; R_0603_1608Metric; Manufacturer_Part_Number ERJ-3GEYJ332V
R42, R47, R48: 10K; R_0603_1608Metric; Manufacturer_Part_Number ERJ-3GEYJ103V
R43: 0R; R_0603_1608Metric; Manufacturer_Part_Number CR0603AJ/-000EAS
R45: 20K; R_0603_1608Metric; Manufacturer_Part_Number ERA-3AEB203V
R49, R50: 0.2R; RES_ERJB1CFR036U; Manufacturer_Part_Number ERJ-D1CFR200U
U9, U11: DRV8825_STEPPER_MOTOR_DRIVER_CARRIER; Manufacturer_Part_Number DRV8825
U10: MCP41010T-I/SN; SOIC-8-1EP_3.9x4.9mm_P1.27mm_EP2.29x3mm; Manufacturer_Part_Number MCP41010T-I/SN
U12, U13: TCMT1600; SOP-4_4.4x2.6mm_P1.27mm; Manufacturer_Part_Number TCMT1600
U14: STSPIN820; QFN_SPIN820_STM; Manufacturer_Part_Number STSPIN820
U15: STSPIN820 Stepper Motor Driver Carrier; SPSPIN820_STEPPER_MOTOR_DRIVER_CARRIER; Manufacturer_Part_Number STSPIN820
U16: UA9637ACP; DIP-8_W7.62mm; Manufacturer_Part_Number UA9637ACDR
U17: ISO7320C; SOIC-8_3.9x4.9mm_P1.27mm; Manufacturer_Part_Number ISO7320CQDRQ1

Connections:
24V: C54.1, C55.1, C56.1, C57.1, C61.2, C64.1, C67.1, C68.2, D7.1 (K), J8.1, J9.1, R40.2, R41.2, U9.16 (VMOT), U11.16 (VMOT), U14.9 (VS), U14.10 (VS), U15.16 (VMOT); also elsewhere on the board
+5V: C62.2, C63.2, C65.1, J10.2, U16.1 (VCC), U17.1 (VCC1); also elsewhere on the board
/MOTOR/A1: MZ2.2 (-), U14.8 (OUTA2), U15.12 (A1)
/MOTOR/A2: MZ2.1, U14.7 (OUTA1), U15.11 (A2)
/MOTOR/B1: MZ2.3, U14.11 (OUTB2), U15.13 (B1)
/MOTOR/B2: MZ2.4, U14.12 (OUTB1), U15.14 (B2)
/MOTOR/EA+: J10.1, U16.8 (IN+)
/MOTOR/EA-: J10.13, U16.7 (IN-)
/MOTOR/EB+: J10.11 (P111), U16.6 (IN+)
/MOTOR/EB-: J10.12, U16.5 (IN-)
/MOTOR/IN+: U16.2 (OUT), U17.2 (INA)
/MOTOR/IN-: U16.3 (OUT), U17.3 (INB)
/MOTOR/VREF: C59.2, U10.6 (PW0), U14.1 (REF)
ENCODER-A: U17.7 (OUTA); also elsewhere on the board
ENCODER-B: U17.6 (OUTB); also elsewhere on the board
GND: C52.1, C53.1, C54.2, C55.2, C56.2, C57.2, C58.2, C59.1, C60.2, C61.1, C62.1, C63.1, C64.2, C65.2, C66.2, C67.2, C68.1, D7.2 (A), J8.3, J9.3, J10.3, J10.4, J10.5, J10.6, J10.7, J10.8, J10.9, J10.10, J10.14, J10.15, Q3.2 (S), R43.1, R47.1, R49.1, R50.1, U9.9 (GND), U9.15 (GND_MOT), U10.4 (VSS), U10.7 (PB0), U11.9 (GND), U11.15 (GND_MOT), U12.3, U13.3, U14.2 (GND), U14.3 (GND), U14.25 (EPAD), U15.9 (GND), U15.15 (GND_MOT), U16.4 (GND), U17.4 (GND1), U17.5 (GND2); also elsewhere on the board
unnamed: J8.2, U12.2
unnamed: J9.2, U13.2
unnamed: MY1.1, U11.11 (A2)
unnamed: MY1.2 (-), U11.12 (A1)
unnamed: MY1.3, U11.13 (B1)
unnamed: MY1.4, U11.14 (B2)
unnamed: MZ1.1, U9.11 (A2)
unnamed: MZ1.2 (-), U9.12 (A1)
unnamed: MZ1.3, U9.13 (B1)
unnamed: MZ1.4, U9.14 (B2)
unnamed: Q3.3 (D), R39.1, U14.17 (ENFAULT)
unnamed: R30.2, U9.2 (M0)
unnamed: R31.2, U9.3 (M1)
unnamed: R32.2, U9.4 (M2)
unnamed: R34.2, U11.2 (M0)
unnamed: R35.2, U11.3 (M1)
unnamed: R36.2, U11.4 (M2)
unnamed: R37.2, U10.5 (PA0)
unnamed: R40.1, U12.1
unnamed: R41.1, U13.1
unnamed: R42.1, R43.2, U14.18 (DECAY)
unnamed: R45.1, U14.16 (STBYRESET)
unnamed: R47.2, U14.24 (TOFF)
unnamed: R49.2, U14.13 (SENSEB2), U14.14 (SENSEB1), U14.15 (SNSB)
unnamed: R50.2, U14.4 (SNSA), U14.5 (SENSEA1), U14.6 (SENSEA2)
RDIR: U14.20 (DIR), U15.8 (DIR); also elsewhere on the board
REN: Q3.1 (G), R38.1, U15.1 (~EN); also elsewhere on the board
RM0: U14.21 (MODE1), U15.2 (M0); also elsewhere on the board
RM1: U14.22 (MODE2), U15.3 (M1); also elsewhere on the board
RM2: R48.1, U14.23 (MODE3), U15.4 (M2)
RSTEP: U14.19 (STCK), U15.7 (STEP); also elsewhere on the board
SPI3_CS: U10.1 (~CS); also elsewhere on the board
SPI3_MOSI: U10.3 (SI); also elsewhere on the board
SPI3_SCK: U10.2 (SCK); also elsewhere on the board
Y-Limit: C60.1, R46.1, U13.4; also elsewhere on the board
YDIR: U11.8 (DIR); also elsewhere on the board
YEN: R33.1, U11.1 (~EN); also elsewhere on the board
YFLT: U11.10 (~FLT)
YSTEP: U11.7 (STEP); also elsewhere on the board
Z-Limit: C58.1, R44.1, U12.4; also elsewhere on the board
ZDIR: U9.8 (DIR); also elsewhere on the board
ZEN: R29.1, U9.1 (~EN); also elsewhere on the board
ZFLT: U9.10 (~FLT); also elsewhere on the board
ZSTEP: U9.7 (STEP); also elsewhere on the board

Notes on the sheet:
Z-axis Stepper Motor
VIH=2.2V VIL=0.7V
Y-axis Stepper Motor
low (mixed decay)
Logic low when in fault condition (overtemp, overcurrent)
(Blue)
https://www.motioncontroltips.com/what-is-current-decay-in-a-stepper-drive/
R-axis Quadrature Encoder
(Red)
(Yellow)
https://www.programmersought.com/article/46654270141/
(Black)
R-axis Stepper Motor
Logic low when in fault condition (overtemp, overcurrent)
(White)
(Green)

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
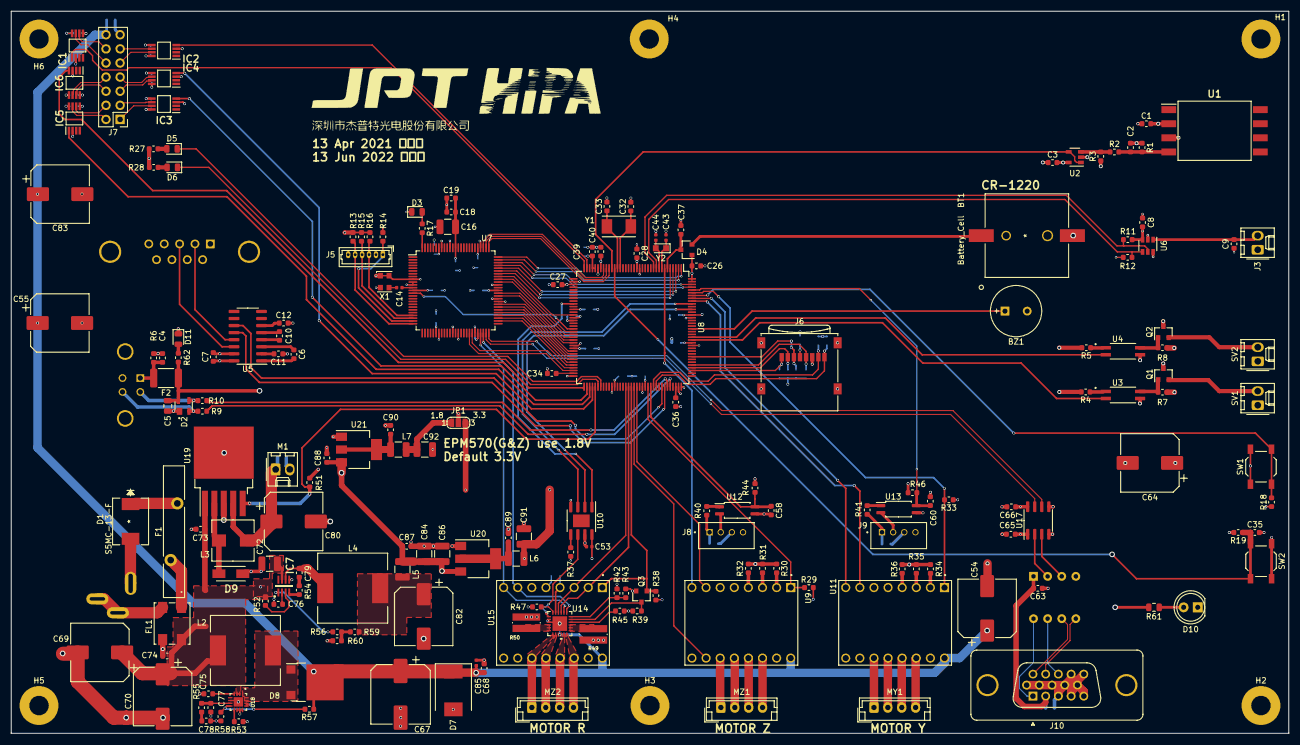
[picture p6: board Pre-Aligner.kicad_pcb from above]

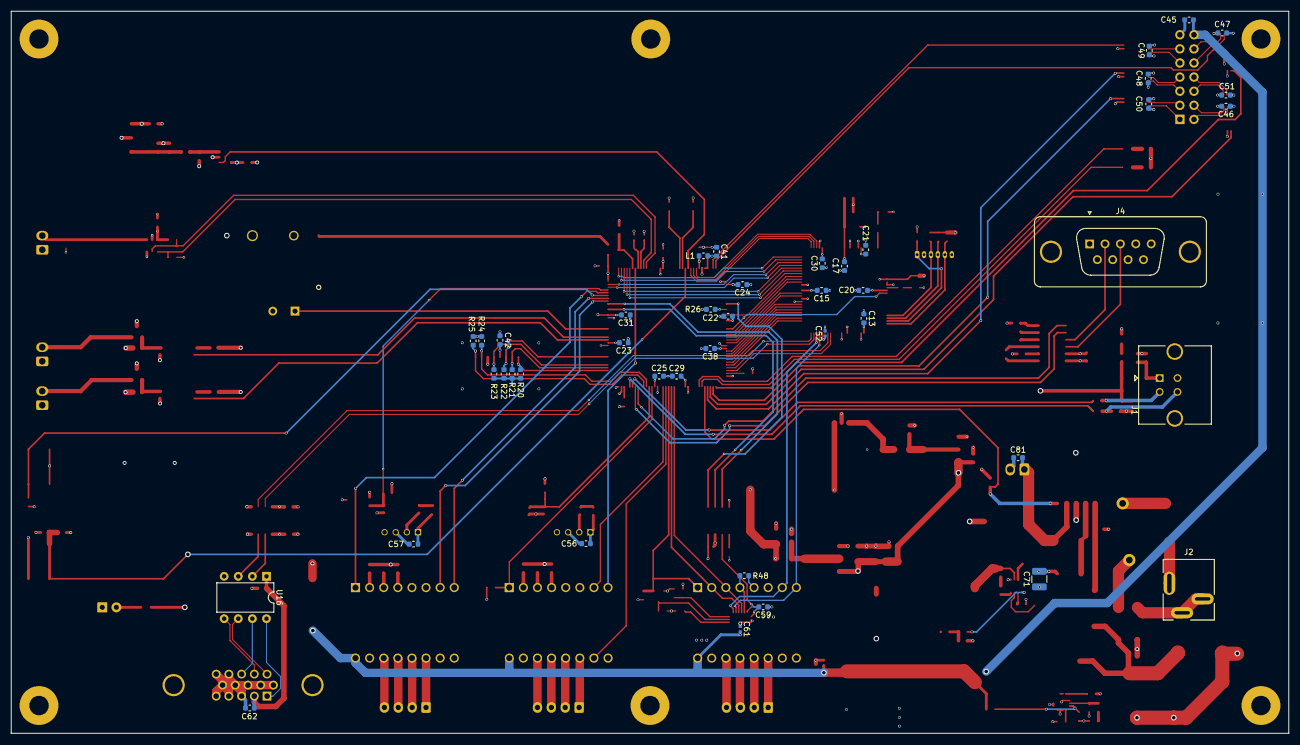
[picture p7: board Pre-Aligner.kicad_pcb from below]

Board: 4 copper layers, 230.0 x 130.0 mm, 238 parts (43 on the bottom side), 191 nets.

Other parts of the board:
G1: LOGO; JPT-LOGO
G2: LOGO; HI_PA_3CM
