liawchinyi/Pre-Aligner/(notices)

Notices in the files:
parts and their libraries:
Copyright 2016 Accelerated Designs. All rights reserved.
Copyright 2021 Accelerated Designs. All rights reserved.
